JakubFialkowski/Modu--pomiarowy/Moduł pomiarowy dla platformy latającej.pdf

## 1. Moduł pomiarowy dla platformy latającej – czujnik jakości

## powietrza

### 1.1. Konstrukcja modułu czujnika jakości powietrza

Zrealizowany został czujnik jakości powietrza służący do pomiaru ilości

zawieszonych cząstek pyłu, stężenia tleneku węgla CO, temperatury oraz wilgotności.

Informacje | zebrane | poprzez | czujniki | przesyłane | są | za | pomocą | systemu

bezprzewodowego do naziemnego odbiornika, który wyświetla dane na wyświetlaczu

lcd.

### 1.1.1. Czujnik pyłu

W celu pomiaru koncentracji pyłu zawieszonego wykorzystano czujnik optyczny

GP2Y1010AU0F firmy SHARP stosowany w systemach oczyszczania powietrza.

Czujnik wyposażony jest w diodę emitującą światło, zestaw soczewek oraz

fototranzystor, który rejestruje światło rozproszone na drobinach zanieczyszczeń.

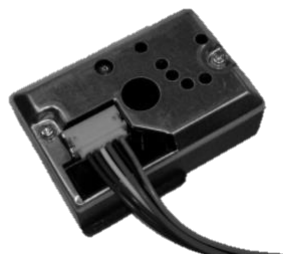
[picture p1: figure]

Rys.1.1. Czujnik pyłu SHARP GP2Y1010AU0F
Czujnik wykrywa cząstki pyłu o średnicy większej niż 0.8μm, co pozwala na

określenie zanieczyszczenia na poziomie PM2,5. Charakteryzuje się wynikiem pomiaru

dostępnym na wyjściu analogowym, którego wartość napięcia jest liniowo proporcjonalna do koncentracji cząstek pyłu w zakresie do 500 µg/m³
. Dopuszczalna
temperatura pracy w zakresie od -10oC do 65oC, natomiast zakładana żywotność podana

przez producenta to 5 lat.

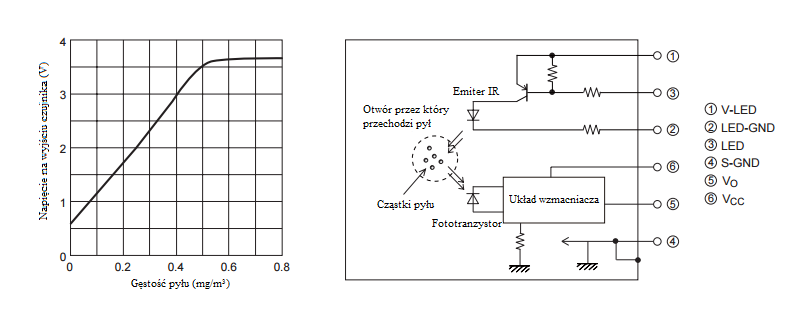
[picture p2: figure]

Rys.1.2. Z lewej charakterystyka napięcia na wyjściu czujnika od gęstości pyłu, z prawej układ

elektryczny czujnika pyłu.

Pomiar odbywa się poprzez generowanie impulsu podczerwieni o czasie trwania

Pw=0,32ms zapewnionym przez kondensator o pojemności C=220µF oraz rezystor o

rezystancji R=150Ω i okresie T=10ms. Następnie po czasie 0,28ms wartość będzie

dostępna w postaci napięcia na pinie analogowym. Wartość gęstości pyłu można obliczyć

korzystając z charakterystyki producenta, przedstawionej na rysunku 1.2. W

dokumentacji czujnika nie określono żadnych przeciwskazań dotyczących miejsca

montażu.

### 1.1.2. Pomiar temperatury oraz wilgotności

Pomiar temperatury oraz wilgotności odbywa się za pomocą czujnika DHT 22. Jest to 8-bitowy cyfrowy czujnik, mierzący temperatury w zakresie od -40oC do 125oC, przy

błędzie pomiarowym ±0,5⁰C oraz wilgotności względnej powietrza od 0% do 100% RH,

z błędem ±5% RH. Czujnik zasilany jest napięciem 3.3V do 6V DC, dane pomiarowe

dostępne są na jednoprzewodowym wyjściu sygnałowym.

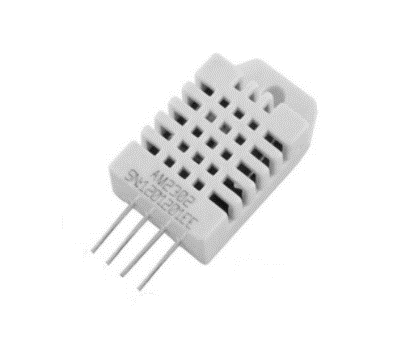
[picture p3: figure]

Rys.1.3 Czujnik temperatury oraz wilgotności DHT22

### 1.1.3. Czujnik tlenku węgla

W celu pomiaru stężenia tlenku węgla CO, który jest niebezpiecznym, bezwonnym,

bezbarwnym gazem, skorzystano z czujnika MQ-7, posiadającego wyjście cyfrowe oraz

analogowe. Wyjście cyfrowe przełącza poziom logiczny wyjścia przy porównaniu

wartości zmierzonej oraz wartości ustawionego progu. Pomiar napięcia wyjścia

analogowego służy do określenia stężenia gazu w powietrzu. Materiałem zastosowanym

do wykrywania CO w czujniku MQ-7 jest SnO2. Pomiar odbywa się metodą cykli

wysokiej i niskiej temperatury, osiąganych za pomocą wbudowanej grzałki. Zakres

pomiaru od 10 do 10000 ppm CO (ang. parts per milion). Głównym powodem

zastosowania była dobra czułość, długi czas działania oraz niski koszt.

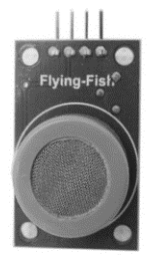
[picture p4: figure]

Rys.1.4. Czujnik MQ-7 tlenku węgla CO

### 1.1.4. Moduł komunikacyjny

W celu przesyłania danych z czujników wykorzystano moduły radiowe nRF24L01,

pełniące funkcję odbiornika i nadajnika, pracujące w pasmie 2,4 GHz. Komunikacja

prowadzona jest poprzez interfejs SPI, moduł posiada sprzętową kolejkę FIFO, a dzięki

dodatkowej antenie zasięg deklarowany przez producenta wynosi do 1000 m. Możliwy

jest wybór prędkości transmisji 250 kbps, 1 Mbps lub 2 Mbps. Pracuje zasilany napięciem

od 1,9 V do 3,6 V, przy bardzo dużej energooszczędności, pobór prądu nadajnika 115

mA ( w szczycie), odbiornika 45 mA ( w szczycie) . Na rysunku 1.5 przedstawiono

moduły odbiorczo – nadawcze, wraz z antenami 110 mm.

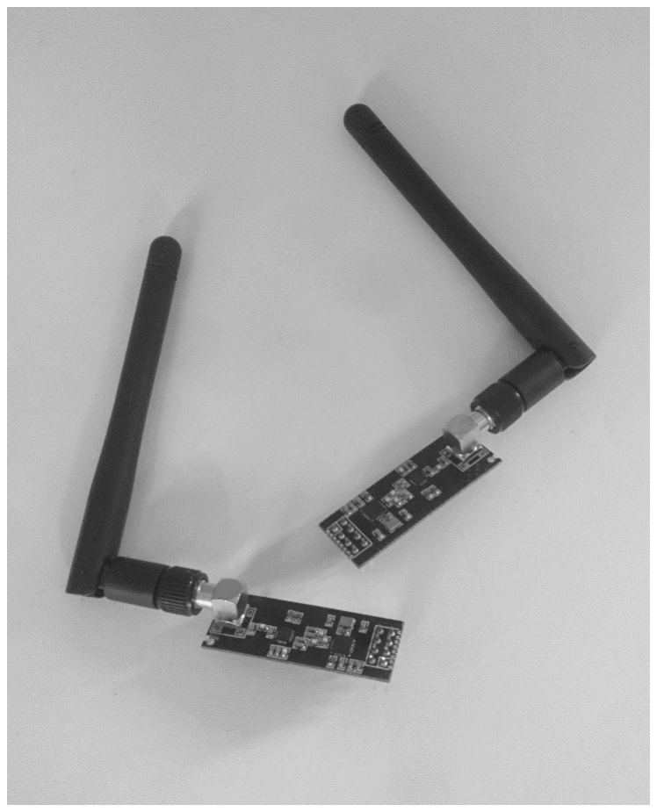
[picture p5: figure]

Rys.1.5. Moduły nadawczo – odbiorcze nRF24L01

### 1.1.5. Kontroler – Arduino NANO

W celu akwizycji danych z czujników oraz obsługi modułu komunikacyjnego po

stronie nadawczej, wykorzystano płytkę Arduino NANO bazującą na mikrokontrolerze

ATmega328P. Układ posiada 14 cyfrowych wejść/wyjść, 8 analogowych wejść, złącze mini usb, komunikacje UART, interfejs I²C oraz SPI. Głównym powodem zastosowania

tego układu była niska masa, wynosząca 4,8g. Dodatkowym atutem są kompaktowe

rozmiary oraz niska cena.

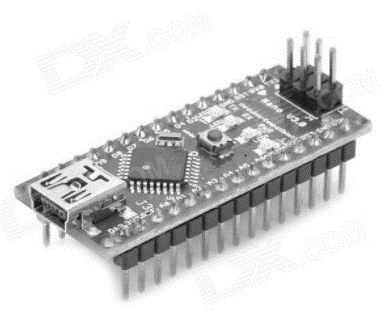
[picture p6: figure]

Rys.1.6 Płytka kontrolera Arduino NANO.

1.2. Kompletny moduł czujnika jakości powietrza.

Podstawę montażową modułu stanowi płytka wykonana z włókna węglowego o

rozmiarach odpowiadających rozmiarowi płyty baterii quadrocoptera, pod którą zostanie

zamocowana. Wykonane zostały wszystkie niezbędne połączenia elektryczne, za pomocą wtyków kołkowych 2,54 mm oraz przewodów o przekroju 0,25 mm²
. Dodatkowo

zastosowano przetwornicę impulsową typu step-down, służącą do zasilania modułu.

Przetwornica zapewnia napięcie 5V oraz prąd do 3A dla czujników oraz płytki

mikrokontrolera. Waga kompletnego modułu wynosi 73 g.

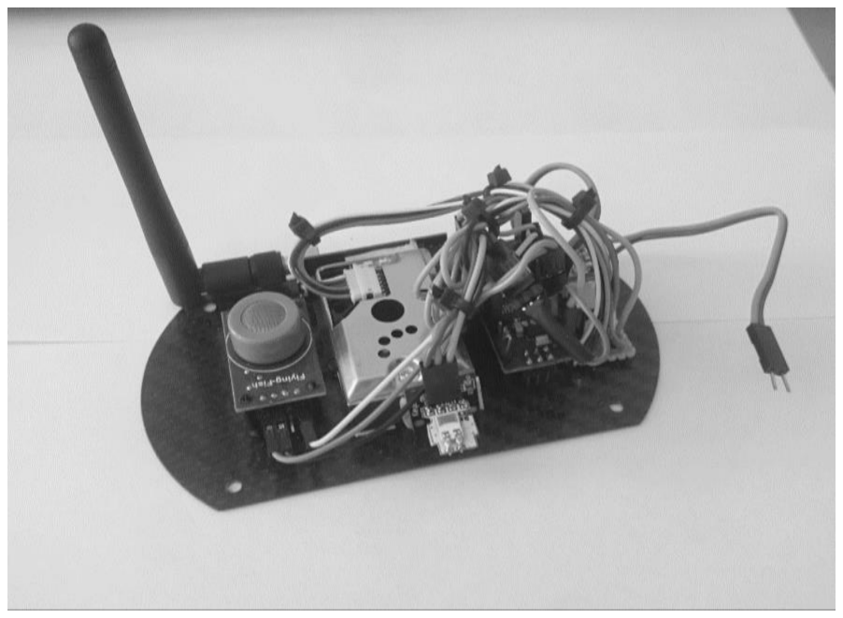
[picture p7: figure]

Rys.1.7. Moduł czujnika czystości powietrza.

### 1.3. Odbiornik danych pomiarowych

W celu prezentacji danych wykonano moduł odbiornika mocowany do nadajnika

RC. Moduł wyposażony jest w:

- Mikrokontroler – Arduino Uno, będące jednostką obsługującą moduł

komunikacyjny oraz wyświetlacza.

- Moduł komunikacyjny - moduł radiowy nRF24L01, służący jako odbiornik.
- Wyświetlacza LCD – Wyświetlacz 4x20 znaków, podświetlany kolorem niebieskim, wyposażony w kontroler magistrali I²C, dzięki której

komunikacja obydwa się za pomocą dwóch przewodów SDA i SCL.

Elektronika zamknięta została w obudowie wykonanej z materiału HIPS - (polistyren

wysokoudarowy). Obudowa posiada kształt prostopadłościanu z wyciętymi niezbędnymi

otworami na wyświetlacz, antenę modułu radiowego, zasilanie płytki arduino oraz port

komunikacji USB. Zasilanie pochodzi z akumulatora zasilającego aparaturę RC, bateria typu Li-pol o napięciu nominalnym 7,4V. Podłączenie zasilania polega na wpięciu

wtyczki typu DC 2.1/5.5 do portu zasilania w płytce arduino. Wymiary modułu wynoszą

110x70x60mm. Moduł może być wyposażony w gniazdo karty SD, służące do rejestracji

pomiarów na karcie pamięci lub moduł transmisji WIFI, który mógłby być wykorzystany

do transmisji danych do komputera przenośnego.

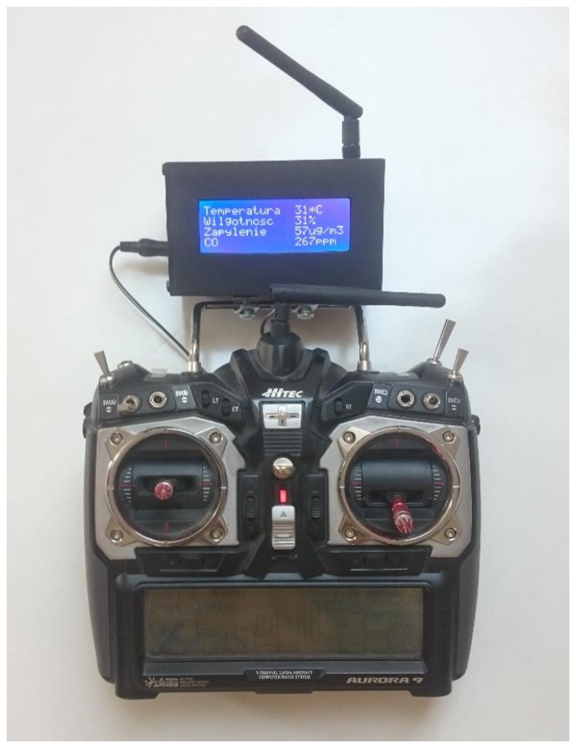
[picture p8: figure]

Rys.1.8. Moduł odbiornika danych pomiarowych wraz z nadajnikiem RC.

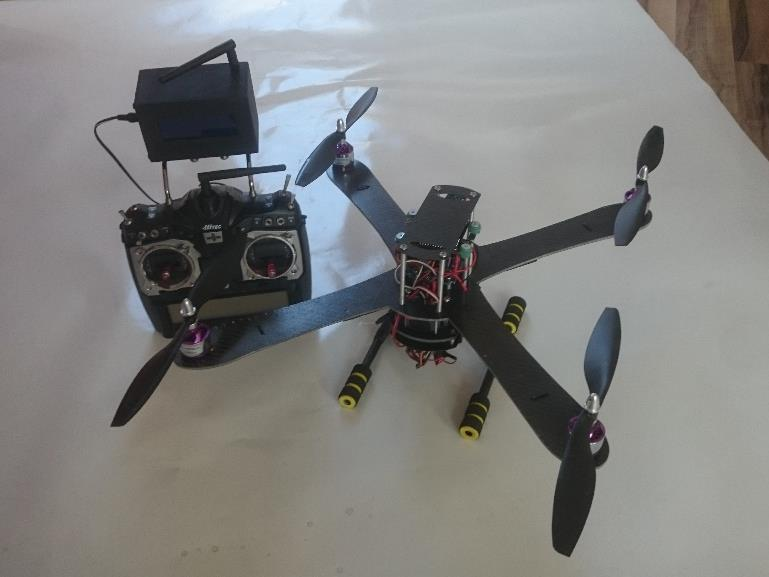
[picture p9: figure]

Rys. 1.9. Latająca platforma wyposażona w moduł pomiarowy.

### 1.4. Oprogramowanie nadajnika oraz odbiornika modułu jakości

powietrza.

Zarówno nadajnik oraz odbiornik pracują na platformie Arduino, więc do

stworzenia oprogramowania wykorzystano środowisko Arduino IDE oraz gotowe

biblioteki dla konkretnych modułów.

1.4.1. Oprogramowanie nadajnika.

Program nadajnika zbiera odczyty z czujników, a następnie wpisuje wykonane

odczyty do tablicy, która następnie przesyłana jest do odbiornika za pomocą modułu

radiowego. Kod programu został załączony w załączniku A. Wykorzystano następujące

biblioteki:

- SPI.h – służąca do obsługi interfejsu SPI
- nRF24L01.h – obsługa modułu komunikacji radiowej
- TimerOne.h – obsługa wbudowanego licznika Timer1
- DHT.h – obsługa czujnika temperatury i wilgotności.
1.4.2. Oprogramowanie odbiornika.

Program odbiornika odbiera dane za pomocą modułu radiowego w postaci tablicy

danych, a następnie wypisuje otrzymane dane na wyświetlaczu LCD. Wykorzystano

biblioteki:

- SPI.h – służąca do obsługi interfejsu SPI
- nRF24L01.h – obsługa modułu komunikacji radiowej
- Wire.h – biblioteka wykorzystywana do obsługi komunikacji I²C
- LiquidCrystal_I2C.h – biblioteka do obsługi wyświetlacza LCD poprzez komunikacje I²C

### 1.5. Przeprowadzone testy czujnika

W celu weryfikacji działania, przeprowadzono testy czujnika polegające na

sprawdzeniu zasięgu urządzenia na otwartej przestrzeni. Moduł czujnika pozostawiono

w miejscu charakterystycznym na szczycie wzniesienia, w celu symulacji lotu na pewnej wysokości. Następnie oddalano się z miejsca położenia czujnika, aż do momentu utraty

transmisji danych. Pokonaną odległość zmierzono przy pomocy aplikacji korzystającej z

map satelitarnych, widocznej na rysunku 1.9.

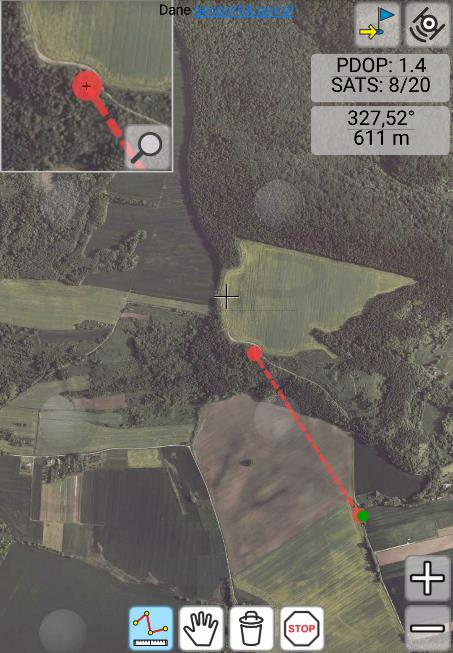
[picture p10: figure]

Rys. 1.9. Zrzut ekranu aplikacji, przy pomocy której dokonano pomiaru odległości.

Zmierzony zasięg wynosi 611 metrów, co jest wynikiem mniejszym niż szacowany

zasięg podany przez producenta 1000 metrów. Zmniejszony zasięg może wynikać z

powodu zastosowania gorszych komponentów modułu przez producenta lub z

nieodpowiedniej konfiguracji programowej urządzenia.

Z racji braku sezonu grzewczego, w celu symulacji dymu wydobywającego się z

kominów domów, rozpalono ognisko. Czujnik umieszczono bezpośrednio w zadymieniu.

Otrzymane wyniki zawarto w tabeli 1.1.

Tab. 1.1. Uzyskane wyniki pomiarów.
Środowisko Rodzaj pomiaru | Dym | Czyste powietrze
Zapylenie | >500 µg/m³ | 10 – 30 µg/m³
CO | > 200 mg/m³ | < 20 mg/m³

Wyniki podawane przez moduł dodatkowo porównano z wynikami najbliższej

stacjonarnej stacji monitoringu czystości powietrza. Niestety wyniki stacji są uśredniane

i aktualizowane co jedną godzinę, więc otrzymane dane nie nadają się do kalibracji

czujników. W tabeli 1.2. zawarto polski indeks jakości powietrza.

Tab.1.2. Polski indeks jakości powietrza.

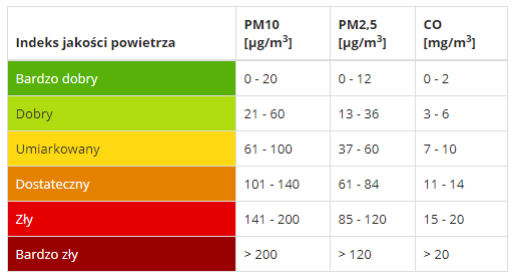
[picture p11: figure]

Wykonane pomiary pokazały małą dokładność czujników pomiarowych,

spowodowaną brakiem koniecznej kalibracji za pomocą profesjonalnych urządzeń

pomiarowych.
